fewomack/BeeHiveMonitoring/README.md

# BeeHiveMonitoring
Please check out "Bee Hive Monitoring System 0.1.pdf" for project information
